Anuttar7/Project_Svarog_public/boom_mould/tooling_spec_and_cutlist.md

# Tooling Specification & Cut List: 500 mm Diagonal Boom Mould

## 1. Tool Assembly Architecture
The boom mould is designed as a split two-piece co-cure tool (Left Flange Tool and Right Flange Tool) clamped together along the central web plane:
- Each half-tool features a convex $90^\circ$ circular mandrel ($R = 15.10\text{ mm}$ nominal), a vertical web face ($10.0\text{ mm}$ height), and horizontal vacuum sealing lands ($25.0\text{ mm}$ width).
- When clamped together face-to-face, the two flanges are laid up and co-cured in a single oven cycle, forming a bonded monolithic TRAC section without secondary adhesive films.

---

## 2. Cut List & Bill of Materials

| Item # | Component Description | Material | Quantity | Dimensions ($L \times W \times T$) | Notes & Prep |
|---|---|---|---|---|---|
| **1** | Tool Base Core (Backing Beam) | Permali / Jabroc Densified Wood | 2 | $550\text{ mm} \times 75\text{ mm} \times 30\text{ mm}$ | Sawn to length; edges chamfered $2\text{ mm}$; sealed with high-temp epoxy. |
| **2** | Precision Convex Face Sheet | Aluminium 6082-T6 / 6061-T6 | 2 | $550\text{ mm} \times 45\text{ mm} \times 1.2\text{ mm}$ | Roll-formed to $R = 15.1\text{ mm}$ $90^\circ$ arc with $10\text{ mm}$ flat web flange. |
| **3** | Longitudinal Datum Pin | Stainless Steel 316 Dowel | 2 | $\varnothing 4.0\text{ mm} \times 20.0\text{ mm}$ | Press fit at $X = 275\text{ mm}$ (mid-span). |
| **4** | Thermal Expansion Relief Fasteners | Stainless Steel Shoulder Screws | 8 | M4 thread, $\varnothing 6\text{ mm}$ shoulder, $8\text{ mm}$ length | Mounts into $8\text{ mm} \times 6.2\text{ mm}$ slotted holes in aluminium sheet. |
| **5** | Tool Half Alignment Dowels | Hardened Ground Steel Dowels | 4 | $\varnothing 8.0\text{ mm} \times 50.0\text{ mm}$ | Locates Left and Right tool halves with $< 0.02\text{ mm}$ misalignment. |
| **6** | Tool Clamping Bolts | High-Tensile Steel Bolts | 4 | M8 $\times 90\text{ mm}$ with prevailing torque nuts | Clamps tool halves across central web during cure. |

---

## 3. High-Temperature Vacuum Bagging Schedule (Easy Composites Consumables)
1. **Release Treatment:**
   - 4 coats of Chemlease 15 Sealer followed by 5 coats of Frekote 700-NC release agent (baked $15\text{ min}$ at $100^\circ\text{C}$ between coats).
2. **Release Film:**
   - Perforated FEP Release Film (P1 release film, rated to $200^\circ\text{C}$).
3. **Breather / Bleeder:**
   - BR180 non-woven polyester breather cloth ($180\text{ g/m}^2$, rated to $205^\circ\text{C}$).
4. **Vacuum Bag Film:**
   - Easy Composites VB200 high-temperature nylon bagging film ($50\,\mu\text{m}$, rated to $204^\circ\text{C}$).
5. **Sealant Tape:**
   - AT-200Y high-temperature yellow mastic sealant tape (rated to $204^\circ\text{C}$).
6. **Through-Bag Vacuum Connector:**
   - TBC2 high-temperature steel through-bag connector with silicone high-temp o-rings.

---

## 4. Quality Control & Acceptance Checklist
- [ ] Tool straightness checked against Class 0 granite surface plate: camber $< 0.15\text{ mm}$ over $550\text{ mm}$.
- [ ] Vacuum drop test at room temperature: $< 10\text{ mbar}$ loss over $15\text{ minutes}$ at $950\text{ mbar}$ vacuum.
- [ ] Thermal soak trial at $180^\circ\text{C}$ for 2 hours with bare bagged tool: verify no bag leakage, no wood outgassing bubbles, and aluminium face sliding freely in slots.
