Anuttar7/Project_Svarog_public/boom_mould/sources.md

# Boom Mould: Citations & Evidence Sources

1. **Task Specification: `icss-briefs/.review/queue/2026-10-30T1300-boom-mould-by-sunday.md`**
   - Oven dimensions ($500 \times 500\text{ mm}$ internal), horizontal placement constraint, wood substrate with thin aluminium sheet face, Easy Composites vacuum bagging.

2. **Fernandez, J. M. (2017) "Advanced Deployable Shell-Based Composite Booms" (NASA TM-2017-219569)**
   - Analysis of mould CTE mismatch: aluminium tooling ($23.4\text{ ppm/}^\circ\text{C}$) produced $2.5\text{ to }12.5\text{ cm}$ tip offsets over $7\text{ m}$ booms; carbon foam tooling ($5.0\text{ ppm/}^\circ\text{C}$) achieved $< 1\text{ cm}$ camber.
   - Spring-in mechanics in curved composite flanges.

3. **Easy Composites Technical Data Sheets (2026)**
   - VB200 Vacuum Bagging Film TDS: Continuous rating $204^\circ\text{C}$, elongation $350\%$.
   - AT-200Y High Temperature Vacuum Sealant Tape TDS: Service temperature up to $204^\circ\text{C}$.
   - BR180 Breather Fabric TDS: Service temperature $205^\circ\text{C}$.

4. **Permali Composites Ltd Technical Data**
   - Densified wood laminate (Permali / Jabroc) thermal rating ($180-200^\circ\text{C}$), in-plane CTE ($5.0 \times 10^{-6}\text{ K}^{-1}$), and outgassing characteristics under vacuum.

5. **Thomas's Obsidian Vault References**
   - `Atlas/Projects/Svarog/Boom-Facts.md` (Section 6: Mould redesign brief).
   - `Atlas/Projects/Svarog/Repo-Map.md` (CAD model measurements).
