Anuttar7/Project_Svarog_public/boom_mould/v5/readability-review-v5.md

# Readability review, Svarog mould v5, 2 Nov 2026

Reviewer: Claude Sonnet 5.5 subagent, fresh context, given page renders of pack_v5.pdf (2 pages), session_2026-11-02.pdf and mould_v5.png plus both HTML sources. Asked for readability, AI-sounding phrasing, contrast framing, em dashes and emoji, judged against Thomas's complaint that v4 was "very hard to read and look AI-written".

| Round | Verdict | Items | Main ones |
|---|---|---|---|
| 1 | FIX | 15 | "nothing ordered" contradicted the open question; session sheet said three screws, pack said one plus two in slots; no glossary for new members; coordinates (x = ±1.20) in the change table; body type 9.6 pt; drawing used x for ×, "130 C", "mu"; coupon table named Radford and Leclerc with no explanation; small drawing text, long leaders, crowded view C |
| 2 | FIX | 8 | larger drawing text made labels collide with the bag outline and dimension lines; doubled border on the notes box; orphaned "°C", "bar" and "0.02"; missing "?" |
| 3 | FIX | 5 | dimension text struck by its own line (fixed by offsetting in points, not data units); "0.5 thick" lost in a rewrap; label wrap in pack section 5 |
| 4 | PASS | 1 optional | the extension line at x = 60 in view C touches the "9" of "90 pitch"; left as is |

No em dashes, emoji or contrast framing were found in any round. The reviewer called the final prose plain and human-written.

What changed because of it: a terms box under the pack title (TRAC, web, flanges, land, liner, spring-in); the change table in millimetres a newcomer can read; body 10 pt and tables 9.5 pt, still 2 pages; the friction-coefficient row dropped from section 4 because section 6 step 2 and the session sheet carry it; the coupon rows say which spring-in model is calculated and which is measured.
