Anuttar7/Project_Svarog_public/boom_mould/v5/mould_v5.pdf

60.4

53.5 10.5

18

block 30.0

wood arc R17.5

tool face R18.0
(liner outer)

liner 1050A-H14,
0.5 thick, 6 return
flange down the side
Al spine 30 × 3, drilled 6 mm at 20 pitch | silicone plug C, Mold Max XLS II

M6 cross bolts, 5 off (hidden), y = -25

pan-head M3
through flange

bag and breather

A | B

A Section through the closed tool, mid-length

web 2 × 0.2 = 0.40

butt gap 2.40

bleed gallery 1 × 1

laminate web ends; liner runs 2.5 further

liner on
web land

liner 0.5

The 0.36 stops sit between the liner faces, at the trim ends only (see C).

B Root detail, enlarged

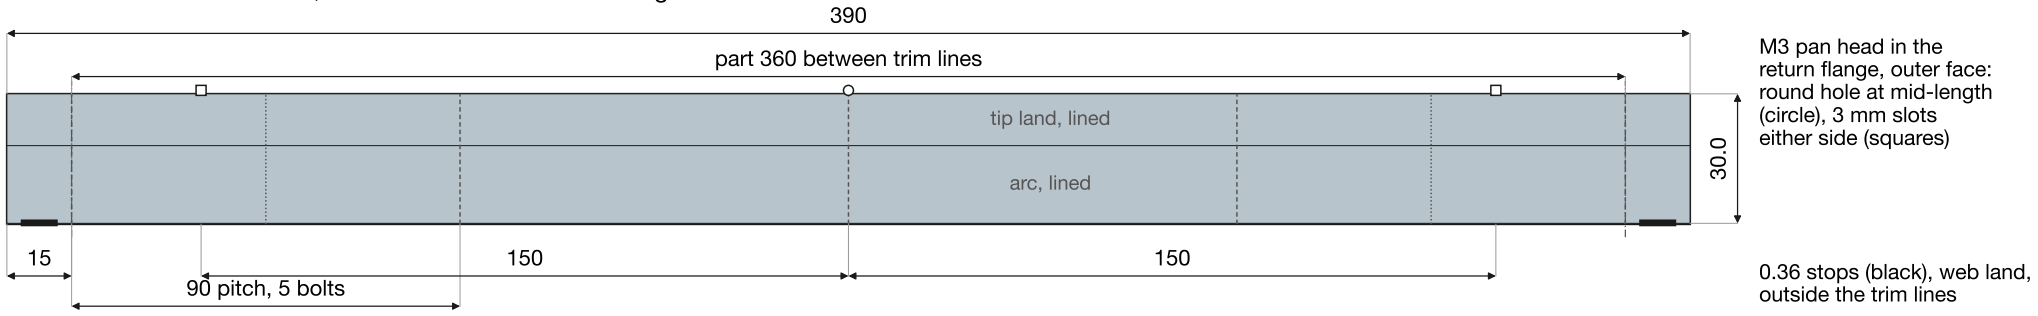
[picture p1: figure]
arc, lined; tip land, lined; part 360 between trim lines; 90 pitch, 5 bolts; M3 pan head in the return flange, outer face: round hole at mid-length (circle), 3 mm slots either side (squares); 0.36 stops (black), web land, outside the trim lines

6 mm reamed dowels at 60 and 330 (dotted)

C Plan of block A from above; B mirrors. Drill both blocks together

form over
the wood arc
R17.5

web
land

tip
land

return

58.4 developed

12.5 | 27.9 | 12

6

length 390; 60 shown. Pre-form over a R14.8 former, fit cold on the block to a 0.1 feeler, trim ends flush.

D Liner blank, flat, 2 per tool

tool face | wood arc | what it tests
R15.2 | R14.7 | spring-in by Radford's thick-laminate formula (calculated)
R16.5 | R16.0 | halfway between rows 1 and 3
R18.0 | R17.5 | spring-in as Leclerc measured (part R = 0.835 × tool R, test data)
R19.6 | R19.1 | spring-in as a fixed change in curvature
R18.0 | R18.0, bare | same as row 3, no liner: does the liner change the part?

Coupon blocks, 5 pairs, 60 long, all in one cure

### Svarog TRAC boom mould, v5

Thomas van Pul | ICSS Project Svarog | 2 Nov 2026
Dimensions in mm, do not scale | A3 | sheet 1 of 1 | supersedes v4

NOTES
1 Wood: one 35 mm phenolic birch strip per block, no glueline. Rough, bake to constant mass, finish, seal.
2 Liner: 1050A-H14, 0.5 mm, micrometer at 3 points (reject spread > 0.02). Not bonded. FEP under it on the web lands, Frekote elsewhere. Measure the friction coefficient ( ) in a 130 °C pull test first; if it is above 0.15 use 5754-H22.
3 Long blocks: rough the arc only until the coupons are read. Finish all arcs on CNC; no stock cutter matches.
4 Plug C: cast on the closed, lined pair over a measured 0.22-0.25 mm spacer. 24 h cure at room temperature.
5 FEP on the tip lands, and under the liner on the web lands. Nothing across the V.
6 Tolerances: web lands flat 0.05 over 390 and parallel 0.05; arc radius ±0.05; root tangent, no step.
