Anuttar7/Project_Svarog_public/boom_mould/v5/session_2026-11-02.pdf

# Svarog structures session

Monday 2 November 2026 · Thomas van Pul · with the new members

1 From Sahil this afternoon

Topic | What he said
Structure changes | An M4 heat-set insert, and an M8 bolt on top to lower the centre-of-mass height.
Structures status | Finalised on the structures side.
Initial design review | With the new members, next Monday or at their next session.
PDR | Stays on the second-last session of term.
Tonight | Ask the new members how confident they feel, and get them thinking about who the subteam lead will be.

Ask Sahil: which part each of the two changes sits on, and whether the M8 bolt adds mass we have not counted.

2 Questions for the new members
1. From 1 to 5, how confident do you feel about the boom and the mould so far? Which part is least clear?
2. What have you done before: CAD, CNC or hand machining, composites lay-up, testing?
3. Which piece would you like to own before the design review: the coupon blocks, the liner and former, the silicone plug, or the structure CAD?
4. Can you make next Monday for the initial design review, or is your next session better?
5. Subteam lead: who would want to be considered? No decision tonight; think about it before the review.

3 Mould, version 5, in two minutes

The tool is the version 4 tool: two plywood blocks, a silicone plug, bagged and cured in the autoclave. The aluminium sheet goes back on, bent over a tighter former first, held by one screw in the middle and two in slots, so it can slide. The coupon run settles the radius and whether the sheet stays. Drawing: mould_v5.pdf. Handout: pack_v5.pdf.

Needed from the team | Who
Cure temperature of the prepreg | ________________
Does the lab vent the bag in the autoclave? | ________________
Was the 1050A sheet ordered, and which temper? | Sahil

Who runs the 130 °C friction pull test? ________________

4 Notes
