Anuttar7/Project_Svarog_public/boom_mould/v4/mould_v4.pdf

C

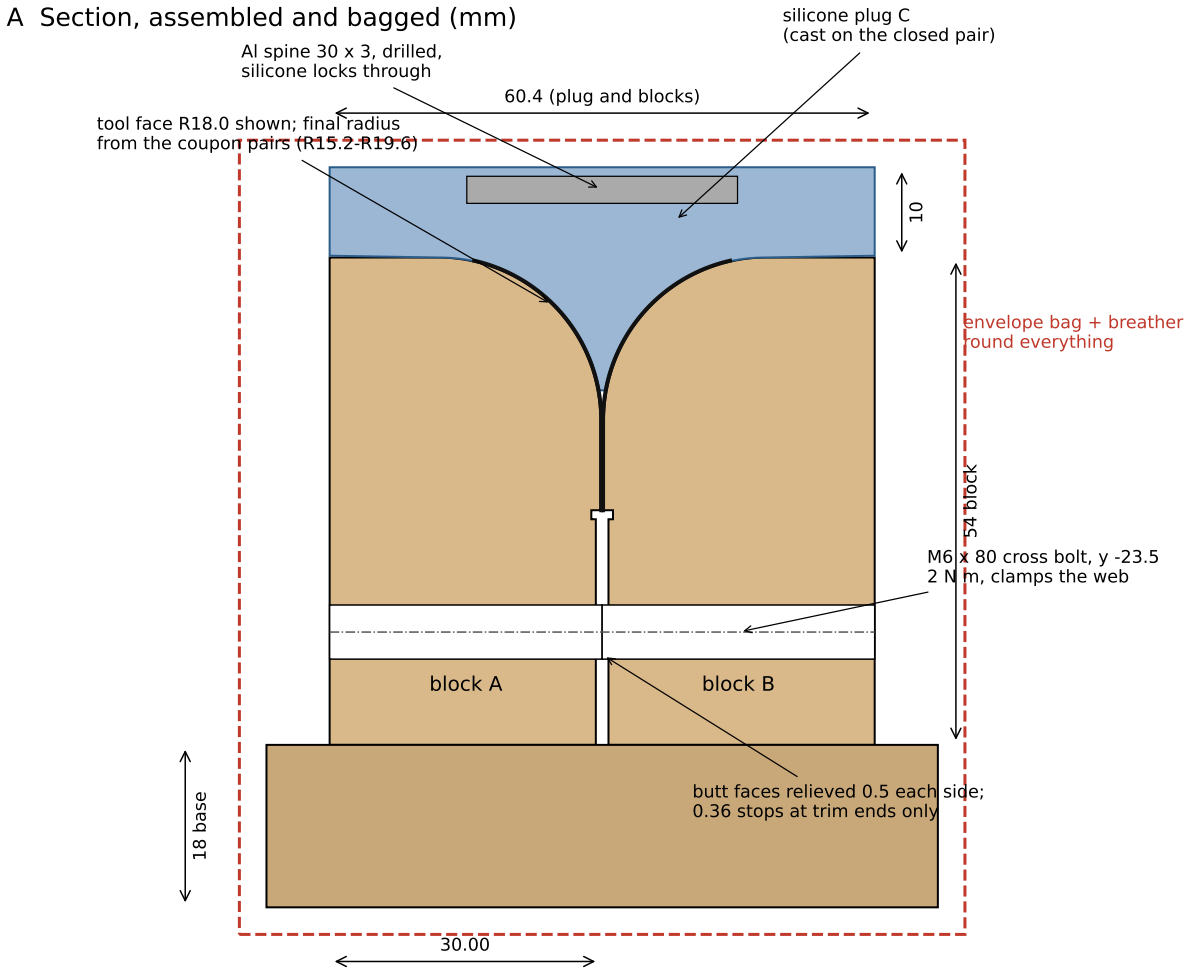
[picture p2: figure]
60.4 (plug and blocks); 54 block; 18 base; tool face R18.0 shown; final radius; from the coupon; pairs (R15.2-R19.6); silicone plug C (cast on the closed pair); Al spine 30 x 3, drilled, silicone locks through; M6 x 80 cross bolt, y -23.5; m, clamps the web; butt faces relieved 0.5 each; side;; 0.36 stops at trim ends only; envelope bag + breather round everything; block A; block B; A Section, assembled and bagged (mm)

A B

### B Exploded: A and B clamp the V, C presses from the top

web 10

plug tip ~3.0 above root
(gap 0.5)

0-3 mm: neither tool fully reaches; section coupon here

bleed gallery 1 x 1

web lands 0.40 apart (cured web)

### C Root detail: web, merge point, plug tip, gallery

390 tool
360 part (red: trim)

12.5

base screws in slotted holes; the slots run ACROSS the tool (seen end-on here) so the blocks can close

plug overhangs
8 each end: free
| to grow ~15 mm

90 pitch, 5 x M6 6 mm reamed dowel (2 off, filled)

at 150 C

D Side elevation of block A (B mirrors; bolt and dowel holes drilled through both blocks together)

Svarog TRAC boom mould v4: closed three-piece tool (2 lower V clamps + silicone top plug), envelope bag round all, autoclave

Tool face R18.0 shown. Spring-in measured on this process (Leclerc et al. 2017/2018, Caltech: mould R12.7 cured R10.6, 90 -> 105 deg) puts the tool ABOVE the part. calc3's R14.83 had the sign backwards. Tomorrow: coupon pairs at R(15.2, 16.5, 18.0, 19.6); ROUGH the long blocks only; finish the arc once the coupons are read. Blocks: one 35 mm phenolic birch strip each, sheet parallel to the web land (no glueline); rough, bake to constant mass, finish, seal.
Plug C: Mold Max XLS II (204 C) cast on the closed pair over a measured 0.22-0.25 mm spacer; drilled Al spine; no FEP across the V.
Clamp: bolts at 2 N m clamp the web as at Caltech; butt faces relieved; autoclave adds 1.4-2.9 MPa (net area ratio 3.6). Bag round everything.
Sources: calc4_output.txt, research-v4-autoclave.md, review-v4-adversarial.md. Draft 2 Nov 2026 for the 18:00 session; nothing cut yet.
