Anuttar7/Project_Svarog_public/Boom/Code/section_diagram.png

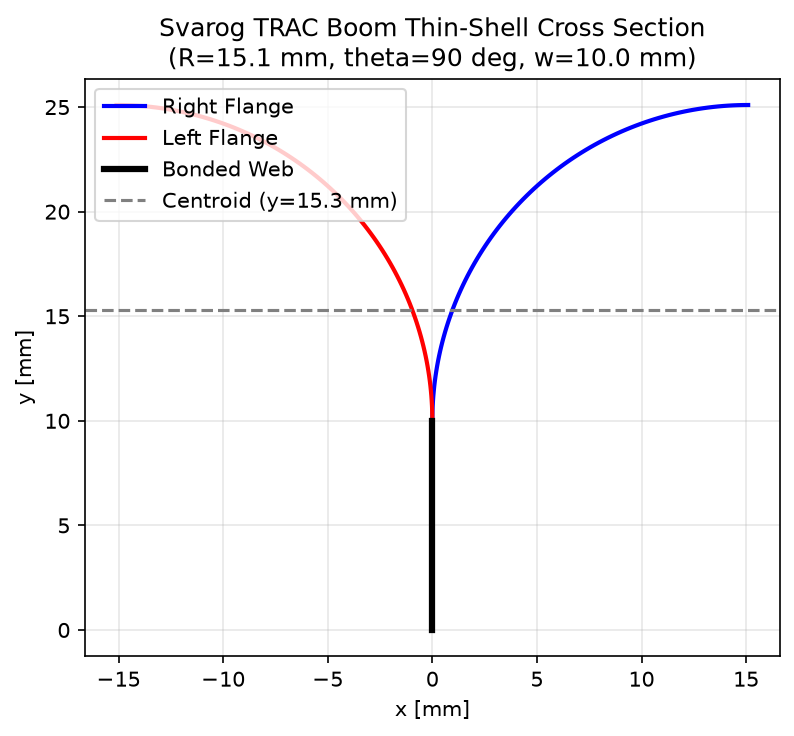
Boom/Code/section_diagram.png
