Anuttar7/Project_Svarog_public/boom_3d/section.png

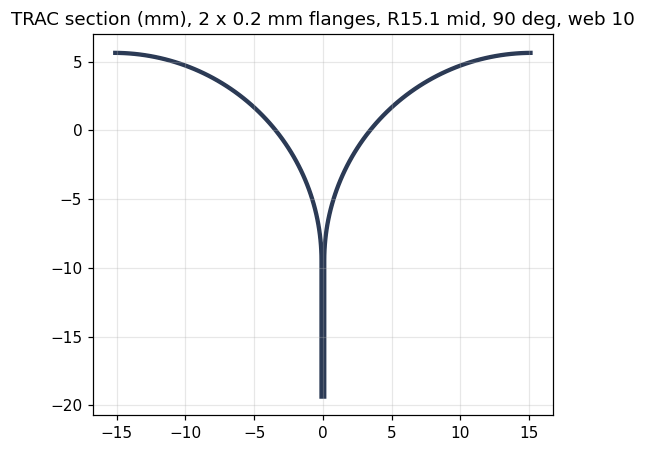
boom_3d/section.png
