Anuttar7/Project_Svarog_public/boom_mould/v5/mould_v5.png

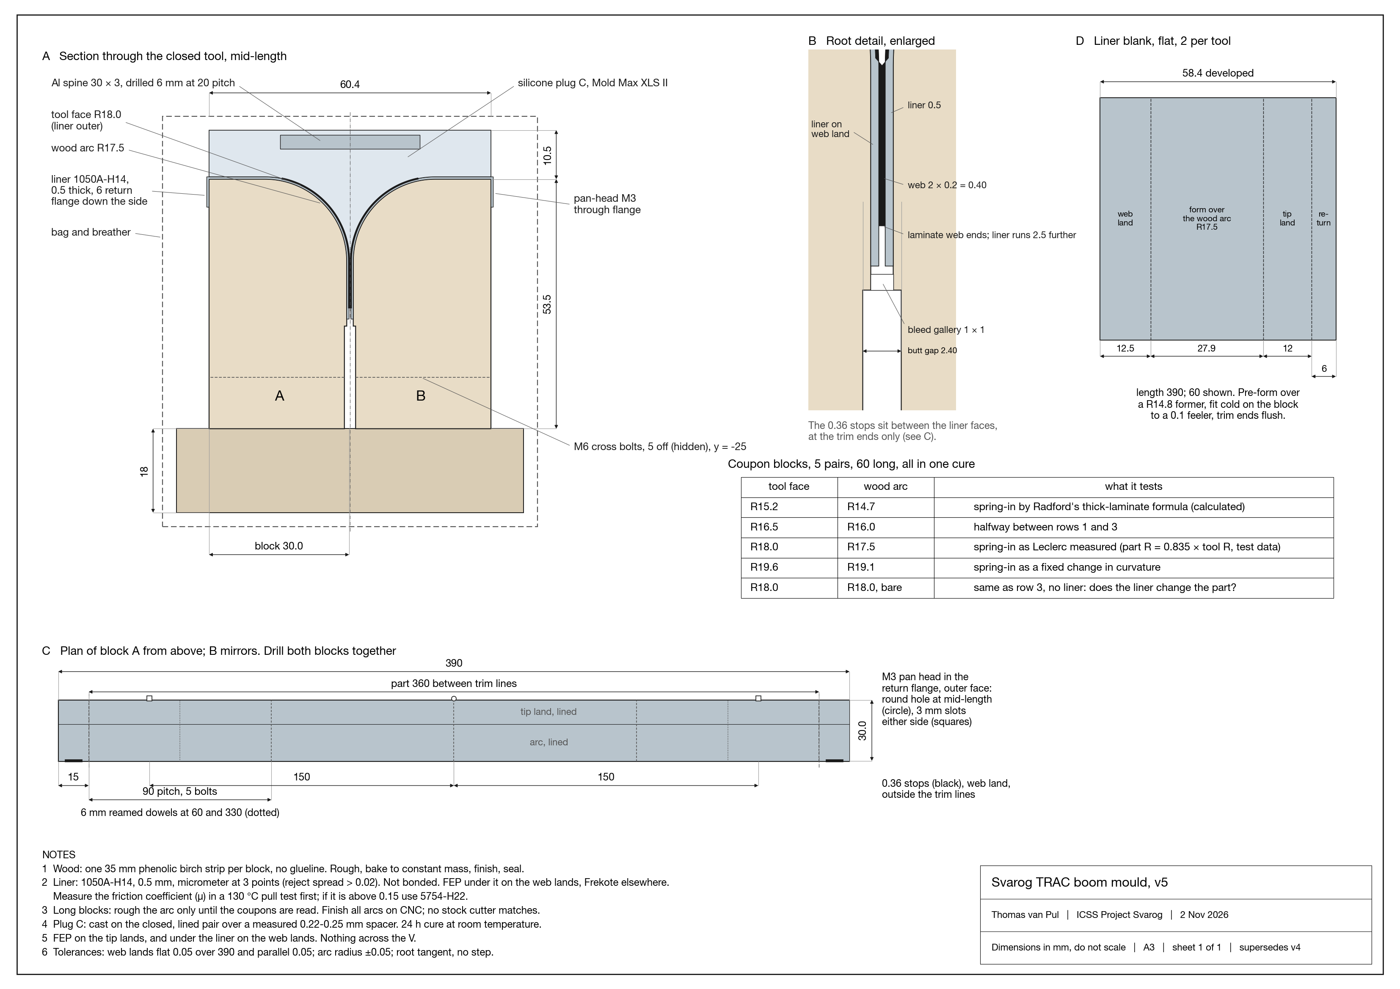
boom_mould/v5/mould_v5.png
