Anuttar7/Project_Svarog_public/boom_3d/spool_with_coiled_boom.step

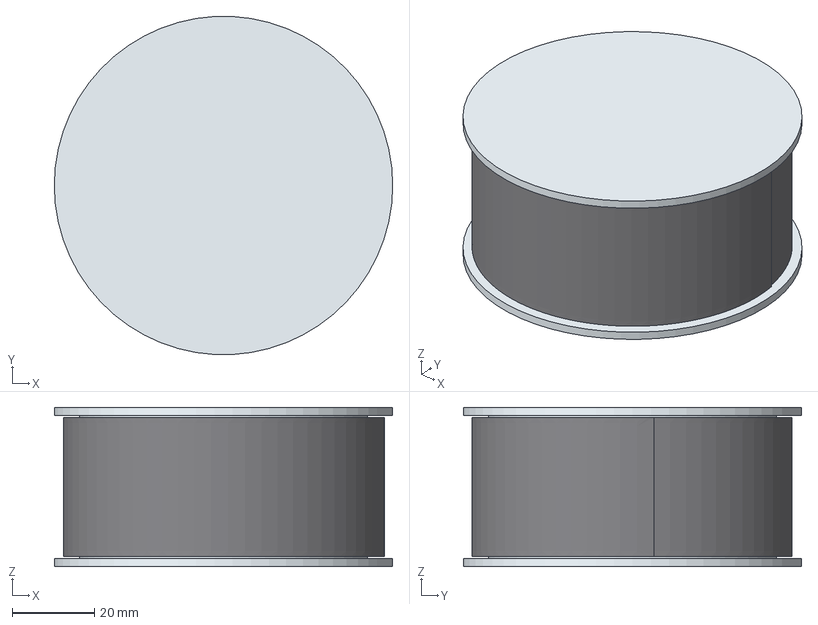
[picture p7: CAD file, 2026-11-02]
boom_3d/spool_with_coiled_boom.step
82.2 x 82.1 x 38.7 mm
boom_coiled
spool_hub
spool_disc_a
spool_disc_b
