Anuttar7/Project_Svarog_public/Composite Booms/Sims+CAD/Composite Boom.step

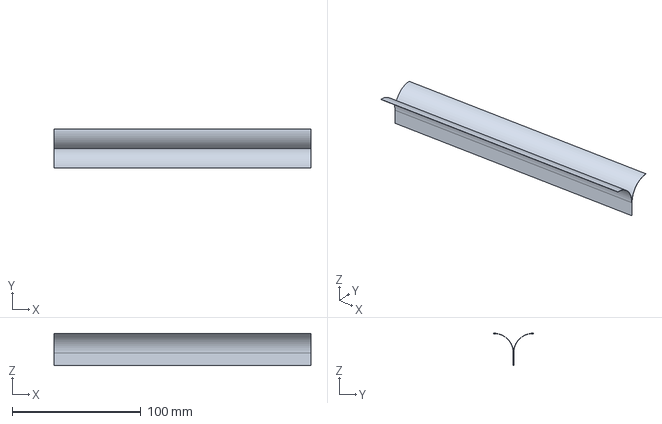
[picture p8: CAD file, 2026-11-02]
Composite Booms/Sims+CAD/Composite Boom.step
200.0 x 30.4 x 25.2 mm
