Anuttar7/Project_Svarog_public/frame_interface/cad/atrium_1u_reference.step

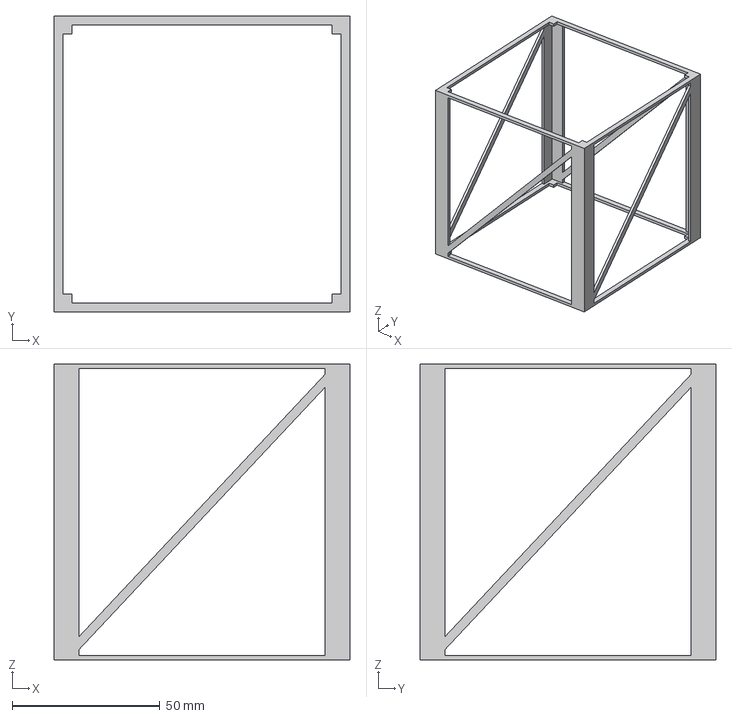
[picture p9: CAD file, 2026-11-02]
frame_interface/cad/atrium_1u_reference.step
100.0 x 100.0 x 100.0 mm
