Anuttar7/Project_Svarog_public/boom_3d/trac_boom_deployed_2100.step

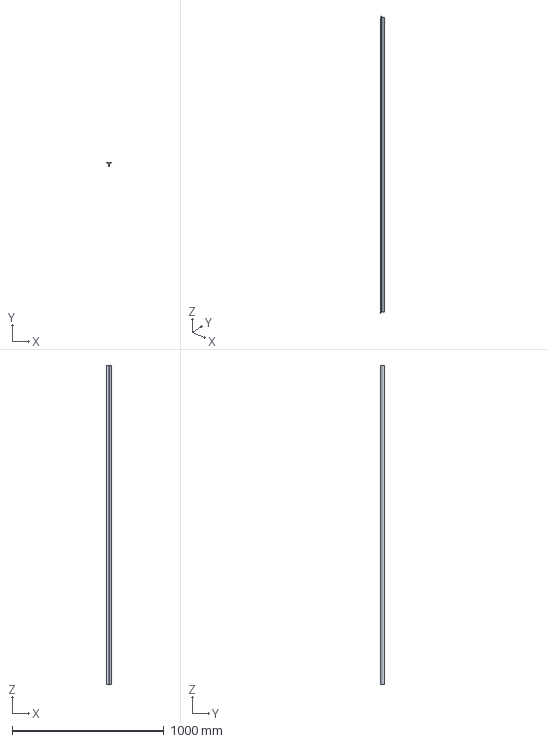
[picture p10: CAD file, 2026-11-02]
boom_3d/trac_boom_deployed_2100.step
30.4 x 25.2 x 2100.0 mm
