Anuttar7/Project_Svarog_public/boom_3d/spool_empty.step

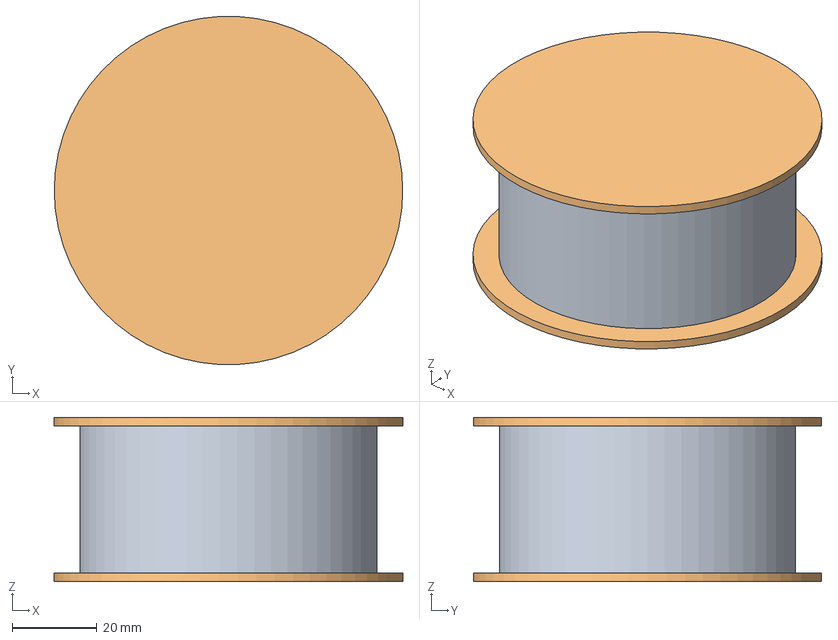
[picture p11: CAD file, 2026-11-02]
boom_3d/spool_empty.step
82.2 x 82.1 x 38.7 mm
