Anuttar7/Project_Svarog_public/boom_3d/trac_boom_coiled.step

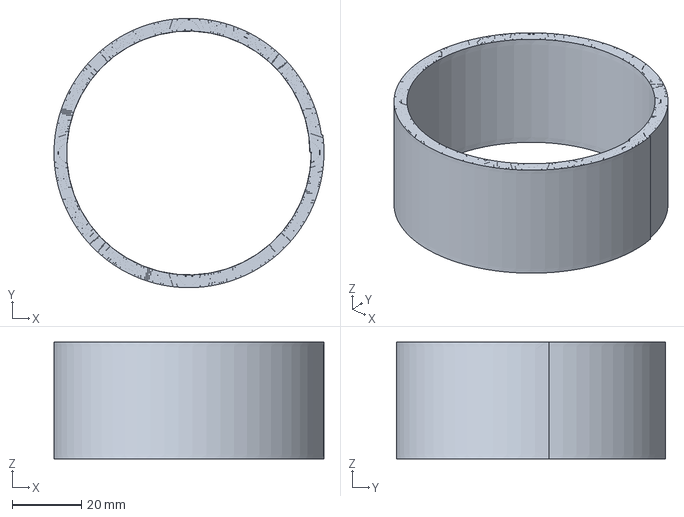
[picture p12: CAD file, 2026-11-02]
boom_3d/trac_boom_coiled.step
78.0 x 77.8 x 33.7 mm
