Anuttar7/Project_Svarog_public/boom_mould/v4/mould_v4.dxf

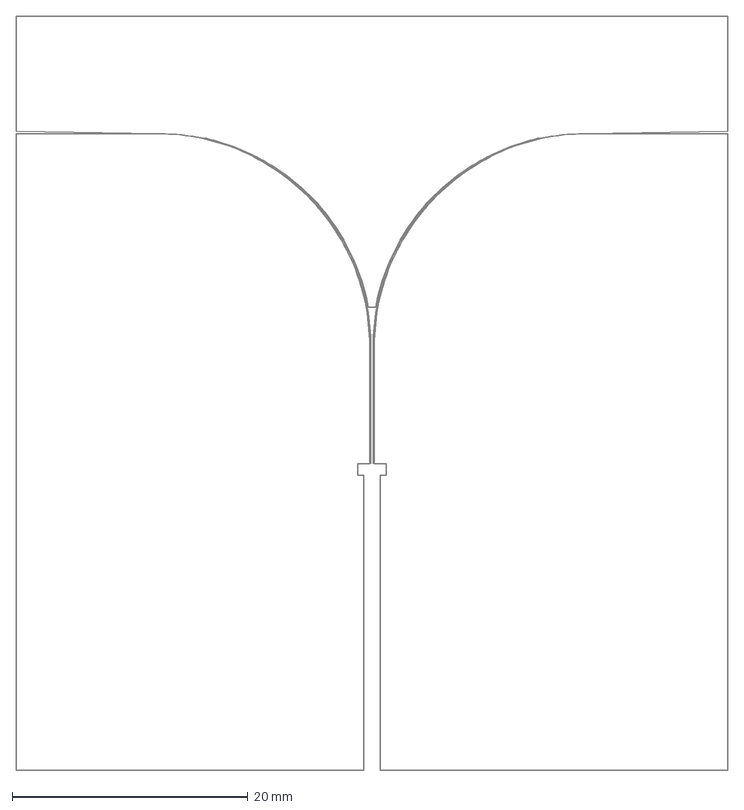
[picture p13: CAD file, 2026-11-02, an earlier design]
boom_mould/v4/mould_v4.dxf
60.4 x 64.0 mm
