Anuttar7/Project_Svarog_public/(list of files, cad)

Other CAD files:
Composite Booms/Sims+CAD/Composite Boom.f3d
boom_3d/spool_empty.stl
boom_3d/spool_with_coiled_boom.stl
boom_3d/trac_boom_coiled.stl
boom_3d/trac_boom_deployed_2100.stl
