Anuttar7/Project_Svarog_public/(commit log)

2026-11-02 Svarog booms
    [Composite Boom Full Length.step, Composite Boom.f3d, Composite Boom.step, atrium_1u_reference.step, mould_v4.dxf]
2026-11-02 feat: parametric 3D model of the TRAC boom (deployed, coiled, spool) as STL and STEP
    [spool_empty.step, spool_empty.stl, spool_with_coiled_boom.step, spool_with_coiled_boom.stl, trac_boom_coiled.step, trac_boom_coiled.stl, trac_boom_deployed_2100.step, trac_boom_deployed_2100.stl]
